nusrobomaster/tiny_stanley/README.md

# tiny_stanley
A minaturised version of our Standard robot, Stanley!
