nusrobomaster/tiny_stanley/pcb_libs/TP4056/TP4056.step

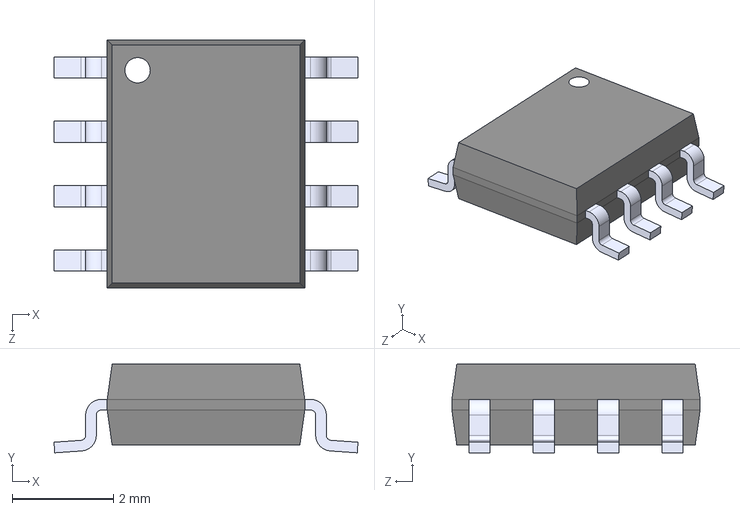
[picture p1: CAD file, 2023-12-12]
pcb_libs/TP4056/TP4056.step
6.00 x 1.75 x 4.90 mm
