nusrobomaster/tiny_stanley/remote/remote_SLDPRTS/Binding cylinder.SLDPRT

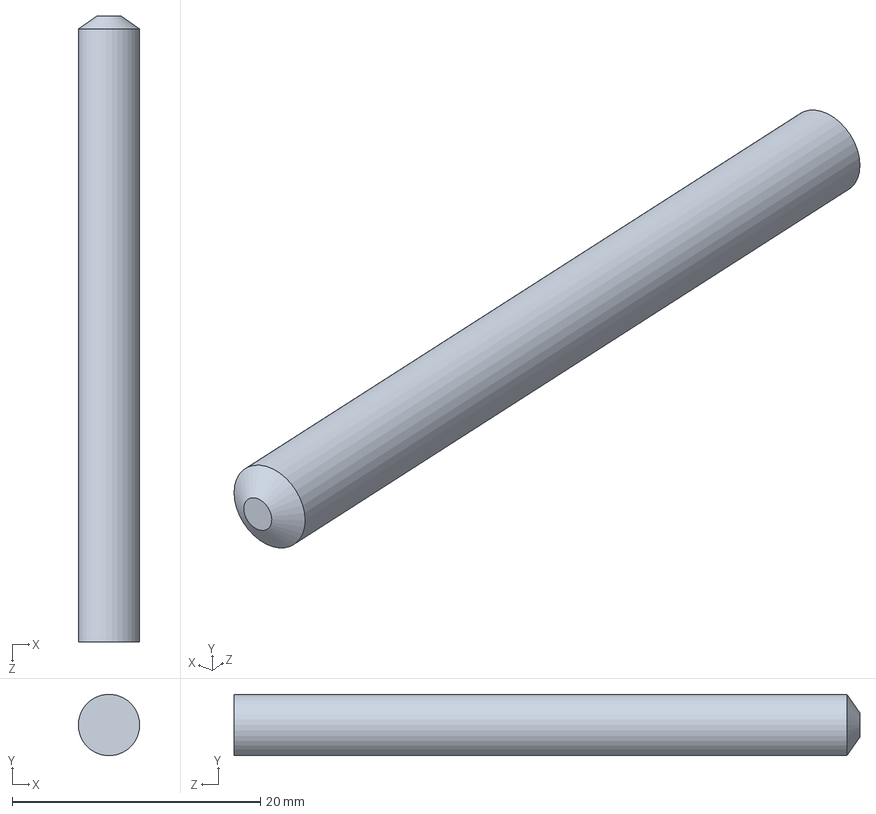
[picture p2: CAD file, 2023-12-23]
remote/remote_SLDPRTS/Binding cylinder.SLDPRT
4.95 x 4.93 x 50.5 mm
