nusrobomaster/tiny_stanley/remote/remote_SLDPRTS/Switch.SLDPRT

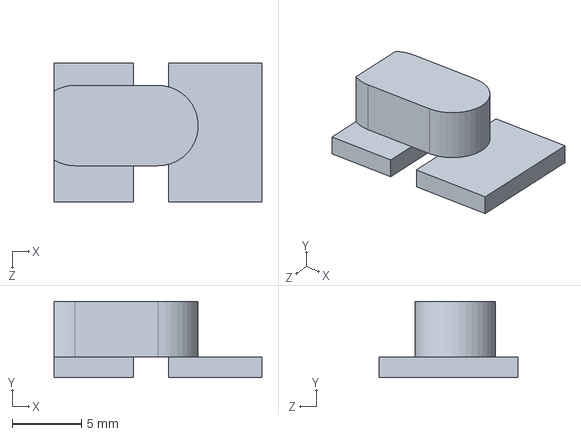
[picture p3: CAD file, 2023-12-23]
remote/remote_SLDPRTS/Switch.SLDPRT
15.0 x 5.50 x 10.0 mm
