nusrobomaster/tiny_stanley/remote/remote_SLDPRTS/Battery cover.SLDPRT

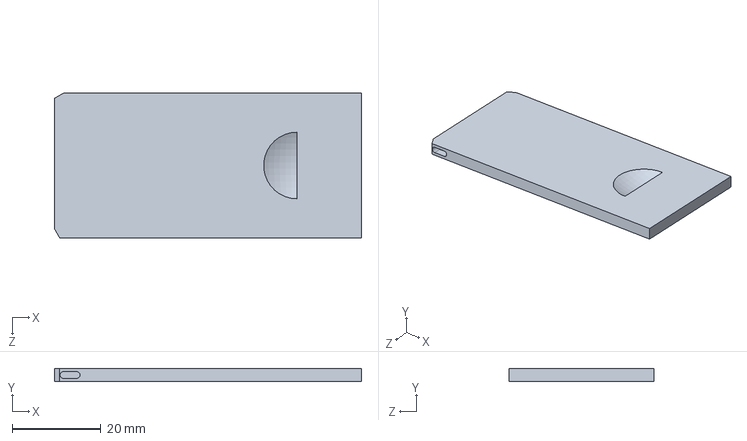
[picture p4: CAD file, 2023-12-23]
remote/remote_SLDPRTS/Battery cover.SLDPRT
69.0 x 3.00 x 32.5 mm
