nusrobomaster/tiny_stanley/remote/remote_SLDPRTS/cr123_holder v3.step

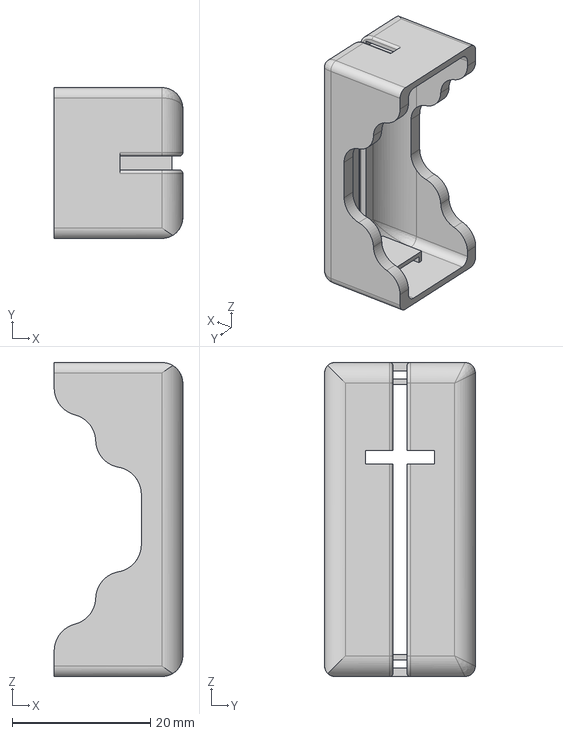
[picture p5: CAD file, 2023-12-23]
remote/remote_SLDPRTS/cr123_holder v3.step
18.6 x 21.8 x 45.4 mm
