nusrobomaster/tiny_stanley/remote/remote_SLDPRTS/AA Battery Case.step

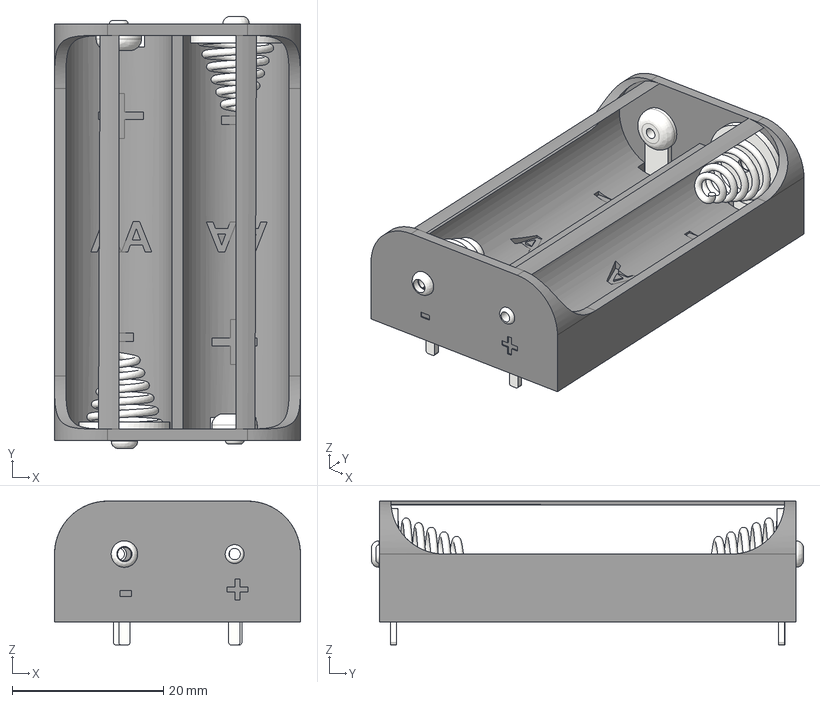
[picture p6: CAD file, 2023-12-23]
remote/remote_SLDPRTS/AA Battery Case.step
32.5 x 57.1 x 19.0 mm
Positive Terminal x 2
AA Battery Case
Negative Terminal x 2
Connecting Plate
