nusrobomaster/tiny_stanley/remote/remote_SLDPRTS/AABattery Holder.stp

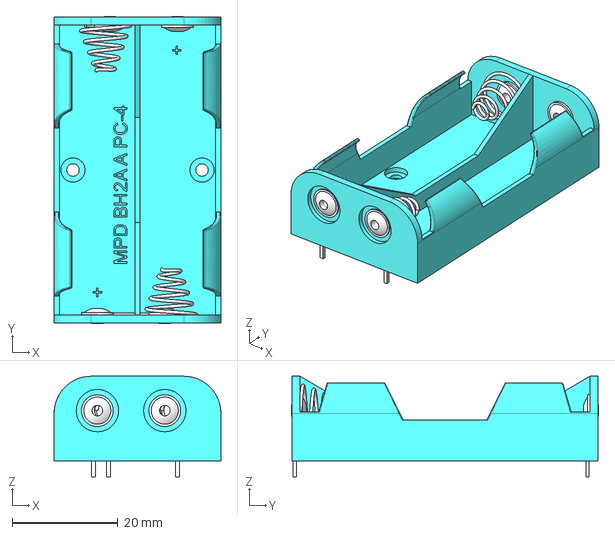
[picture p7: CAD file, 2023-12-23]
remote/remote_SLDPRTS/AABattery Holder.stp
31.5 x 58.0 x 19.0 mm
