nusrobomaster/tiny_stanley/remote/remote_SLDPRTS/Circuit cover.SLDPRT

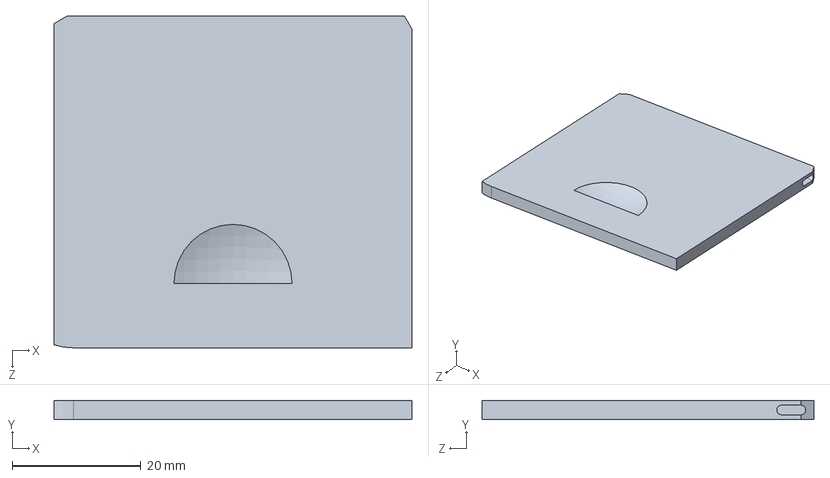
[picture p8: CAD file, 2023-12-23]
remote/remote_SLDPRTS/Circuit cover.SLDPRT
55.6 x 3.00 x 51.5 mm
