nusrobomaster/tiny_stanley/remote/remote_SLDPRTS/Battery cover v2.SLDPRT

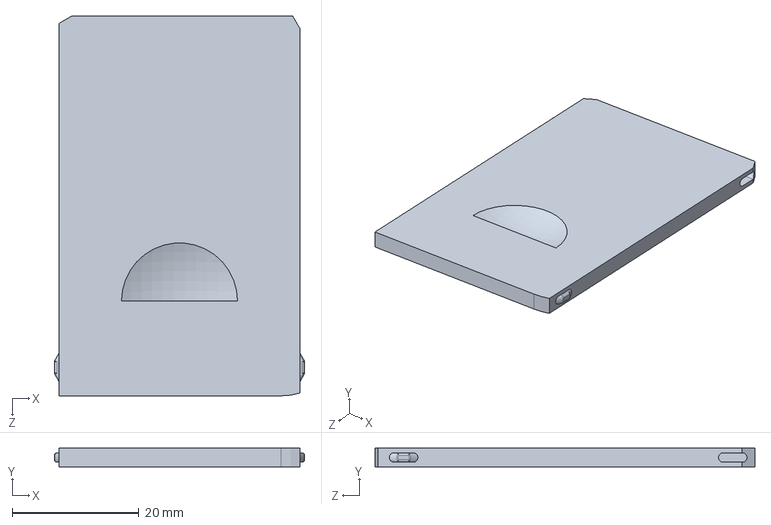
[picture p9: CAD file, 2023-12-23]
remote/remote_SLDPRTS/Battery cover v2.SLDPRT
39.5 x 3.00 x 60.0 mm
