nusrobomaster/tiny_stanley/remote/remote_SLDPRTS/Controller box v2.SLDPRT

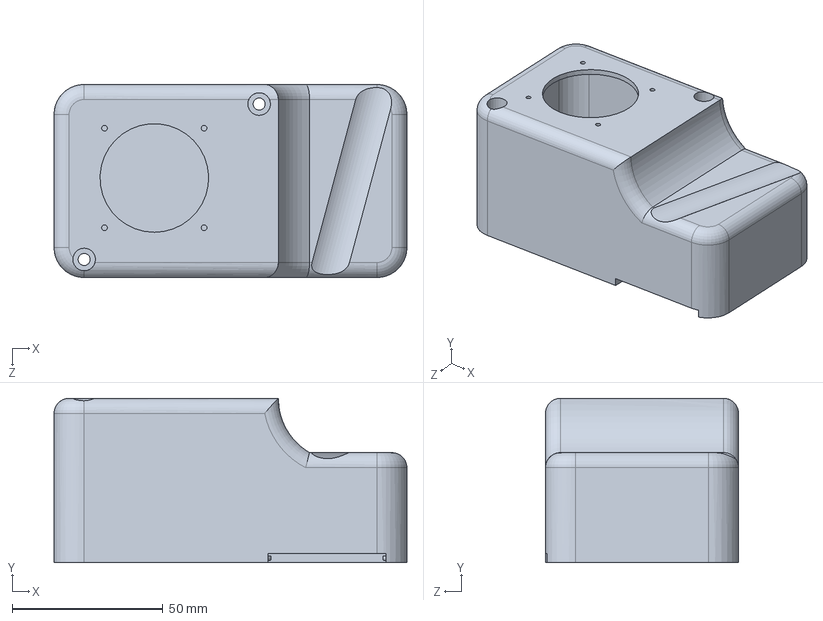
[picture p10: CAD file, 2023-12-23]
remote/remote_SLDPRTS/Controller box v2.SLDPRT
117.0 x 54.5 x 64.0 mm
