nusrobomaster/tiny_stanley/remote/remote_SLDPRTS/Controller box.SLDPRT

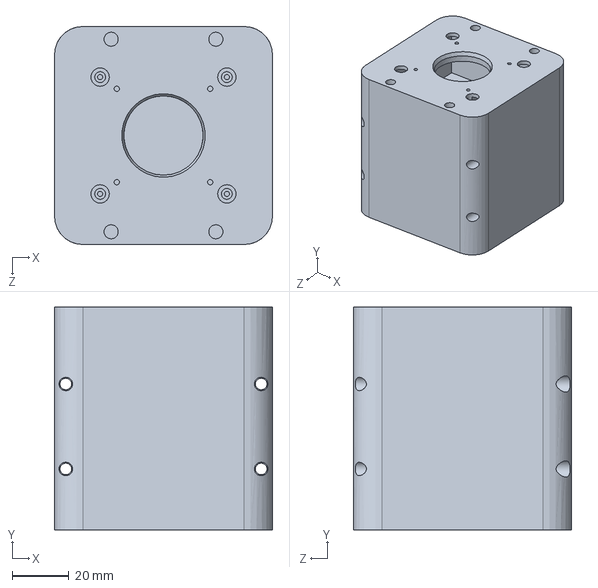
[picture p11: CAD file, 2023-12-23]
remote/remote_SLDPRTS/Controller box.SLDPRT
77.0 x 78.6 x 77.0 mm
