nusrobomaster/tiny_stanley/(list of files, cad)

Other CAD files:
remote/remote_SLDPRTS/STL files/Battery cover v2.STL
remote/remote_SLDPRTS/STL files/Battery cover.STL
remote/remote_SLDPRTS/STL files/Binding cylinder.STL
remote/remote_SLDPRTS/STL files/Circuit cover.STL
remote/remote_SLDPRTS/STL files/Controller box v2.STL
remote/remote_SLDPRTS/STL files/Controller box.STL
remote/remote_SLDPRTS/STL files/Switch.STL
