nusrobomaster/tiny_stanley/remote/remote_pcb/remote_pcb.kicad_pcb

## KiCad design remote/remote_pcb/remote_pcb.kicad_pcb (2023-12-12)

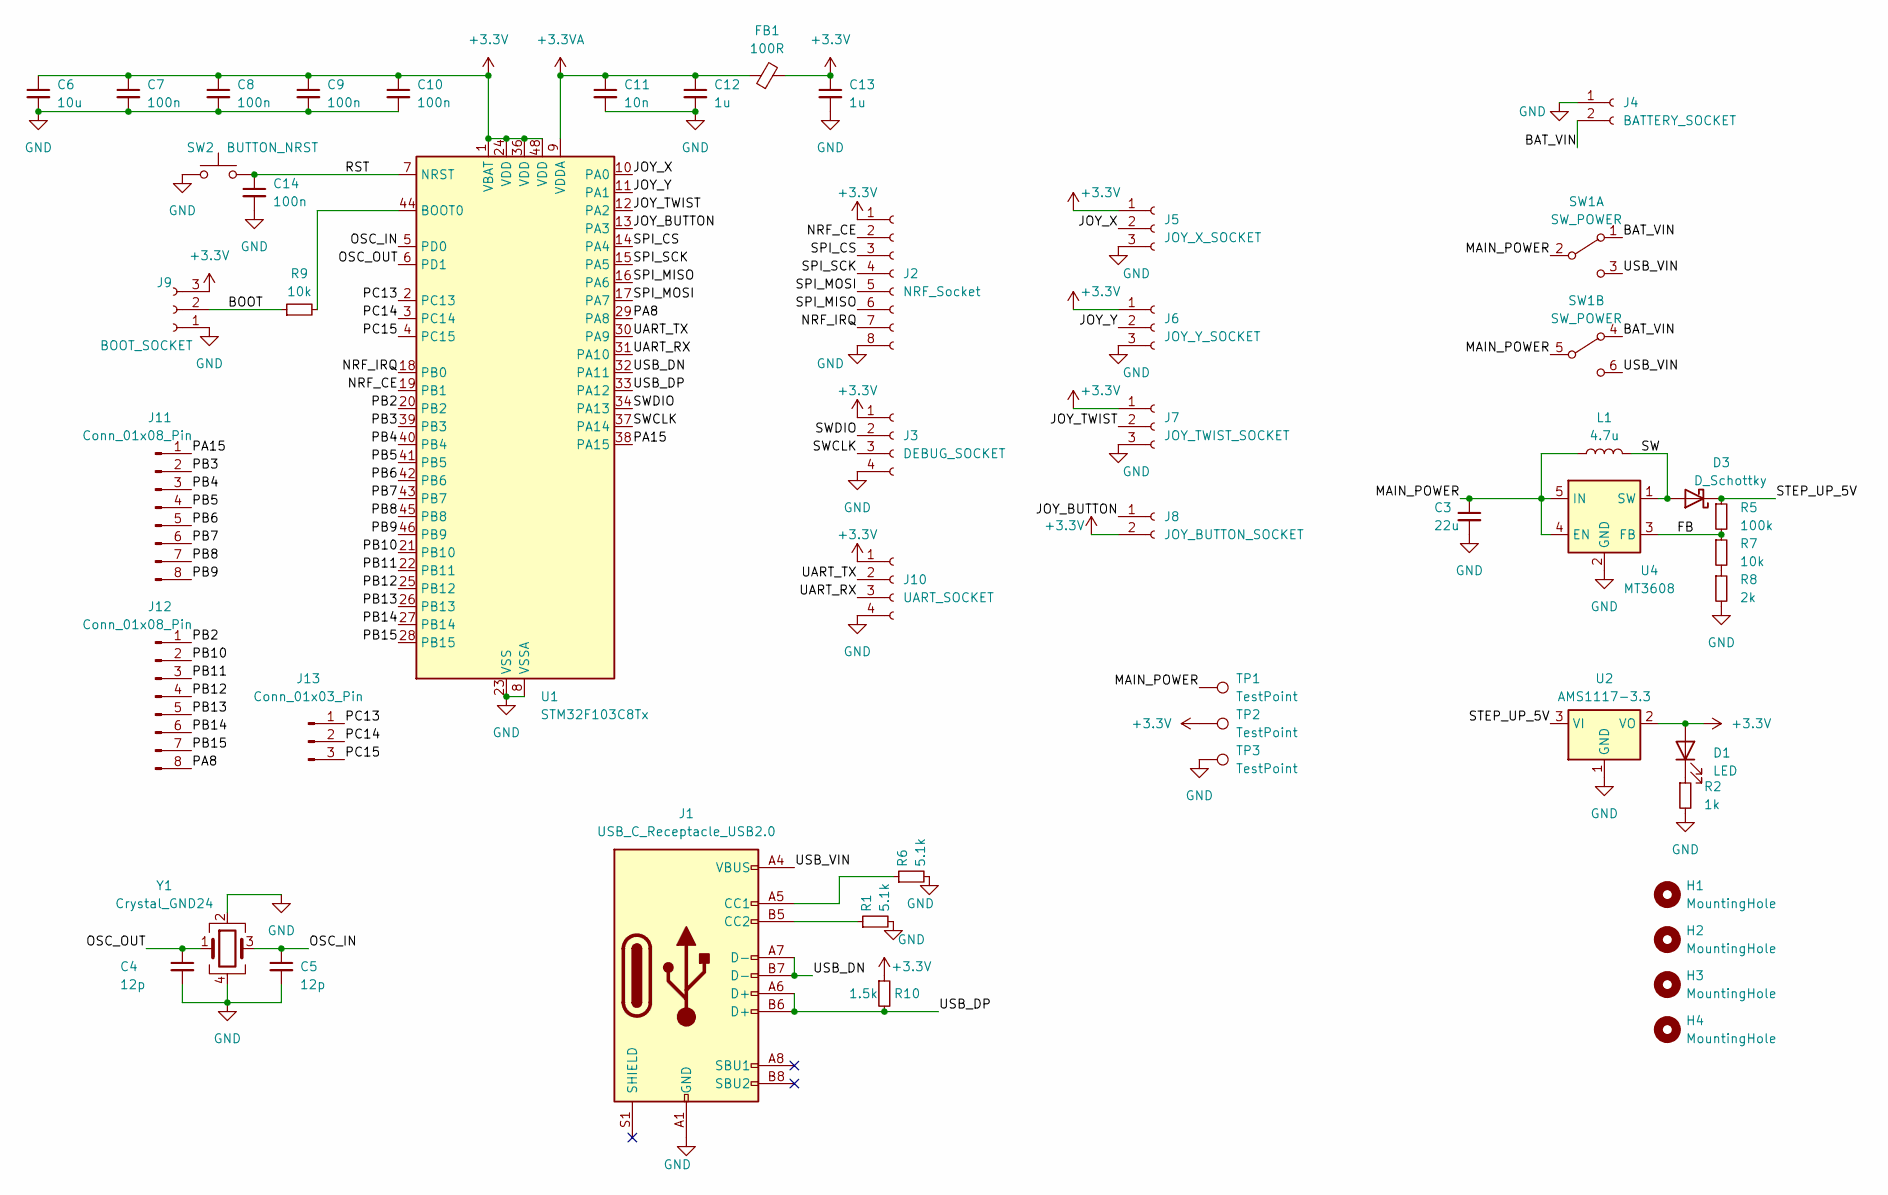
[picture p12: schematic remote_pcb.kicad_sch]

Parts:
C3: 22u; C_1210_3225Metric_Pad1.33x2.70mm_HandSolder
C4, C5: 12p; C_0402_1005Metric_Pad0.74x0.62mm_HandSolder
C6: 10u; C_0805_2012Metric_Pad1.18x1.45mm_HandSolder
C7, C8, C9, C10, C14: 100n; C_0402_1005Metric_Pad0.74x0.62mm_HandSolder
C11: 10n; C_0402_1005Metric_Pad0.74x0.62mm_HandSolder
C12, C13: 1u; C_0402_1005Metric_Pad0.74x0.62mm_HandSolder
D1: LED; LED_0603_1608Metric_Pad1.05x0.95mm_HandSolder
D3: D_Schottky; D_SOD-123
FB1: 100R; L_1206_3216Metric_Pad1.22x1.90mm_HandSolder
H1, H2, H3, H4: MountingHole; MountingHole_2.1mm
J1: USB_C_Receptacle_USB2.0; USB_C_Receptacle_HRO_TYPE-C-31-M-12
J2: NRF_Socket; NRF24L01
J3: DEBUG_SOCKET; PinHeader_1x04_P2.54mm_Vertical
J4: BATTERY_SOCKET; PinHeader_1x02_P2.54mm_Vertical
J5: JOY_X_SOCKET; JST_PH_S3B-PH-K_1x03_P2.00mm_Horizontal
J6: JOY_Y_SOCKET; JST_PH_S3B-PH-K_1x03_P2.00mm_Horizontal
J7: JOY_TWIST_SOCKET; JST_PH_S3B-PH-K_1x03_P2.00mm_Horizontal
J8: JOY_BUTTON_SOCKET; JST_PH_S2B-PH-K_1x02_P2.00mm_Horizontal
J9: BOOT_SOCKET; PinHeader_1x03_P2.54mm_Vertical
J10: UART_SOCKET; PinHeader_1x04_P2.54mm_Vertical
J11, J12: Conn_01x08_Pin; PinHeader_1x08_P2.54mm_Vertical
J13: Conn_01x03_Pin; PinHeader_1x03_P2.54mm_Vertical
L1: 4.7u; L_Coilcraft_XAL5020-XXX
R1, R6: 5.1k; R_0402_1005Metric_Pad0.72x0.64mm_HandSolder
R2: 1k; R_0402_1005Metric_Pad0.72x0.64mm_HandSolder
R5: 100k; R_0402_1005Metric_Pad0.72x0.64mm_HandSolder
R7, R9: 10k; R_0402_1005Metric_Pad0.72x0.64mm_HandSolder
R8: 2k; R_0402_1005Metric_Pad0.72x0.64mm_HandSolder
R10: 1.5k; R_0402_1005Metric_Pad0.72x0.64mm_HandSolder
SW1: SW_POWER; SW_CuK_JS202011AQN_DPDT_Angled
SW2: BUTTON_NRST; SW_Tactile_SPST_NO_Straight_CK_PTS636Sx25SMTRLFS
TP1, TP2, TP3: TestPoint; TestPoint_Pad_1.0x1.0mm
U1: STM32F103C8Tx; LQFP-48_7x7mm_P0.5mm
U2: AMS1117-3.3; SOT-223-3_TabPin2
U4: MT3608; SOT-23-6
Y1: Crystal_GND24; Crystal_SMD_3225-4Pin_3.2x2.5mm

Connections:
+3.3V: C6.1, C7.1, C8.1, C9.1, C10.1, C13.1, D1.2 (A), FB1.2, J2.1, J3.1, J5.1, J6.1, J7.1, J8.2, J9.3, J10.1, R10.1, TP2.1, U1.1 (VBAT), U1.24 (VDD), U1.36 (VDD), U1.48 (VDD), U2.2 (VO)
+3.3VA: C11.1, C12.1, FB1.1, U1.9 (VDDA)
/BAT_VIN: J4.2, SW1.1 (A), SW1.4 (A)
/BOOT: J9.2, R9.1
/FB: R5.2, R7.1, U4.3 (FB)
/JOY_BUTTON: J8.1, U1.13 (PA3)
/JOY_TWIST: J7.2, U1.12 (PA2)
/JOY_X: J5.2, U1.10 (PA0)
/JOY_Y: J6.2, U1.11 (PA1)
/MAIN_POWER: C3.1, L1.1, SW1.2 (B), SW1.5 (B), TP1.1, U4.4 (EN), U4.5 (IN)
/NRF_CE: J2.2, U1.19 (PB1)
/NRF_IRQ: J2.7, U1.18 (PB0)
/OSC_IN: C5.1, U1.5 (PD0), Y1.3
/OSC_OUT: C4.1, U1.6 (PD1), Y1.1
/PA8: J12.8, U1.29 (PA8)
/PA15: J11.1, U1.38 (PA15)
/PB2: J12.1, U1.20 (PB2)
/PB3: J11.2, U1.39 (PB3)
/PB4: J11.3, U1.40 (PB4)
/PB5: J11.4, U1.41 (PB5)
/PB6: J11.5, U1.42 (PB6)
/PB7: J11.6, U1.43 (PB7)
/PB8: J11.7, U1.45 (PB8)
/PB9: J11.8, U1.46 (PB9)
/PB10: J12.2, U1.21 (PB10)
/PB11: J12.3, U1.22 (PB11)
/PB12: J12.4, U1.25 (PB12)
/PB13: J12.5, U1.26 (PB13)
/PB14: J12.6, U1.27 (PB14)
/PB15: J12.7, U1.28 (PB15)
/PC13: J13.1, U1.2 (PC13)
/PC14: J13.2, U1.3 (PC14)
/PC15: J13.3, U1.4 (PC15)
/RST: C14.1, SW2.2, U1.7 (NRST)
/SPI_CS: J2.3, U1.14 (PA4)
/SPI_MISO: J2.6, U1.16 (PA6)
/SPI_MOSI: J2.5, U1.17 (PA7)
/SPI_SCK: J2.4, U1.15 (PA5)
/STEP_UP_5V: D3.1 (K), R5.1, U2.3 (VI)
/SW: D3.2 (A), L1.2, U4.1 (SW)
/SWCLK: J3.3, U1.37 (PA14)
/SWDIO: J3.2, U1.34 (PA13)
/UART_RX: J10.3, U1.31 (PA10)
/UART_TX: J10.2, U1.30 (PA9)
/USB_DN: J1.A7 (D-), J1.B7 (D-), U1.32 (PA11)
/USB_DP: J1.A6 (D+), J1.B6 (D+), R10.2, U1.33 (PA12)
/USB_VIN: J1.A4 (VBUS), J1.A9 (VBUS), J1.B4 (VBUS), J1.B9 (VBUS), SW1.3 (C), SW1.6 (C)
GND: C3.2, C4.2, C5.2, C6.2, C7.2, C8.2, C9.2, C10.2, C11.2, C12.2, C13.2, C14.2, J1.A1 (GND), J1.A12 (GND), J1.B1 (GND), J1.B12 (GND), J2.8, J3.4, J4.1, J5.3, J6.3, J7.3, J9.1, J10.4, R1.2, R2.2, R6.2, R8.2, SW2.1, TP3.1, U1.8 (VSSA), U1.23 (VSS), U1.35 (VSS), U1.47 (VSS), U2.1 (GND), U4.2 (GND), Y1.2, Y1.4
unnamed: D1.1 (K), R2.1
unnamed: J1.A5 (CC1), R6.1
unnamed: J1.B5 (CC2), R1.1
unnamed: R7.2, R8.1
unnamed: R9.2, U1.44 (BOOT0)

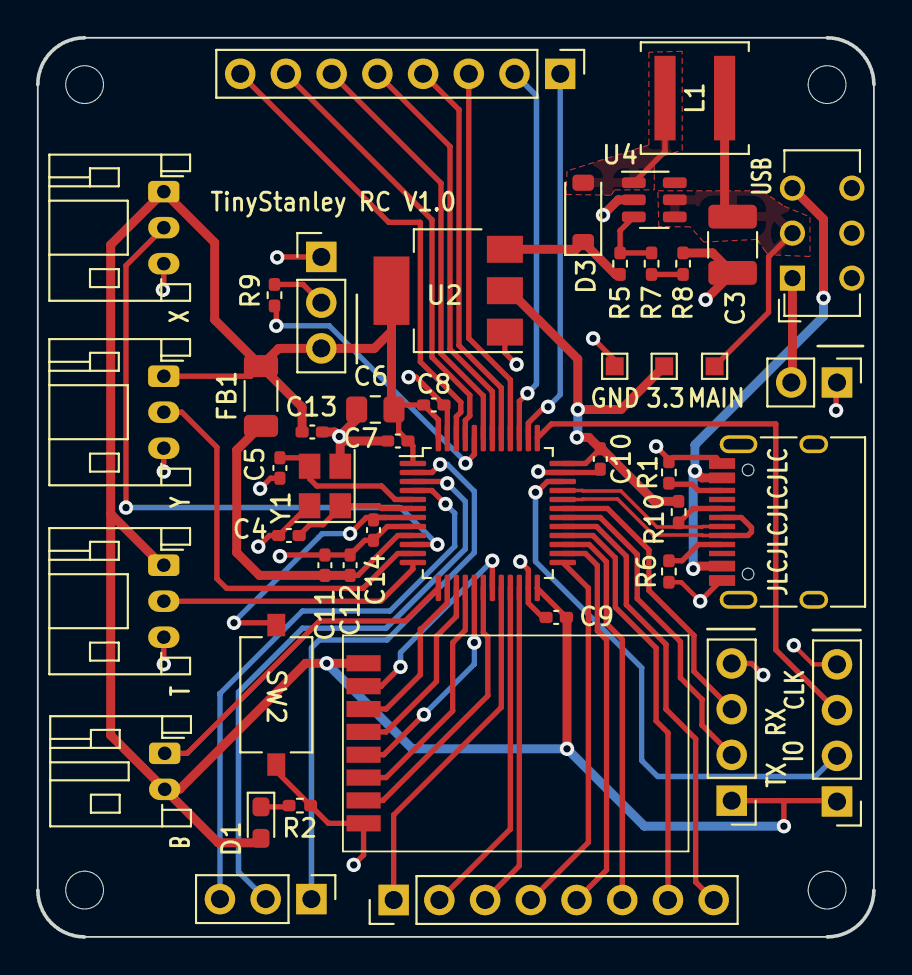
[picture p13: board remote_pcb.kicad_pcb from above]

Board: 2 copper layers, 46.5 x 50.0 mm, 50 parts (0 on the bottom side), 53 nets.
