nusrobomaster/tiny_stanley/remote/remote_firmware/remote_firmware.ioc

Mcu.UserName=STM32F103C8Tx
PA0-WKUP.Signal=ADCx_IN0
PA1.Signal=ADCx_IN1
PA11.Signal=USB_DM
PA12.Signal=USB_DP
PA13.Signal=SYS_JTMS-SWDIO
PA14.Signal=SYS_JTCK-SWCLK
PA2.Signal=ADCx_IN2
PA3.GPIO_Label=JOY_BUTTON
PA3.Signal=GPIO_Input
PA4.GPIO_Label=SPI1_CS
PA4.Signal=GPIO_Output
PA5.Signal=SPI1_SCK
PA6.Signal=SPI1_MISO
PA7.Signal=SPI1_MOSI
PB0.GPIO_Label=NRF_IRQ
PB0.Signal=GPXTI0
PB1.GPIO_Label=NRF_CE
PB1.Signal=GPIO_Output
PD0-OSC_IN.Signal=RCC_OSC_IN
PD1-OSC_OUT.Signal=RCC_OSC_OUT
