nusrobomaster/tiny_stanley/remote/remote_firmware/Core/Inc/main.h

#define JOY_BUTTON_Pin GPIO_PIN_3
#define JOY_BUTTON_GPIO_Port GPIOA
#define SPI1_CS_Pin GPIO_PIN_4
#define SPI1_CS_GPIO_Port GPIOA
#define NRF_IRQ_Pin GPIO_PIN_0
#define NRF_IRQ_GPIO_Port GPIOB
#define NRF_IRQ_EXTI_IRQn EXTI0_IRQn
#define NRF_CE_Pin GPIO_PIN_1
#define NRF_CE_GPIO_Port GPIOB
