nusrobomaster/tiny_stanley/(notices)

Notices in the files:
remote/remote_firmware/Core/Src/gpio.c:
Copyright (c) 2023 STMicroelectronics.
All rights reserved.
This software is licensed under terms that can be found in the LICENSE file
